pljakobs/Nebelhorn/Front Panel.FCStd

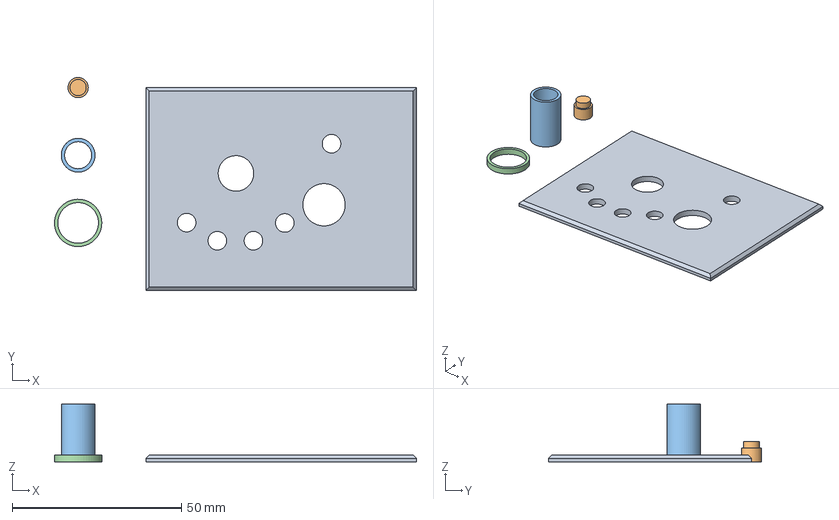
[picture p1: CAD file, 2023-03-14]
Front Panel.FCStd
107.0 x 63.0 x 17.0 mm
Panel
Lightpipe
Shroud
Shim
