pljakobs/Nebelhorn/Nebelhorn-D2PAK.kicad_sch

## KiCad design Nebelhorn-D2PAK.kicad_sch (2023-03-14)

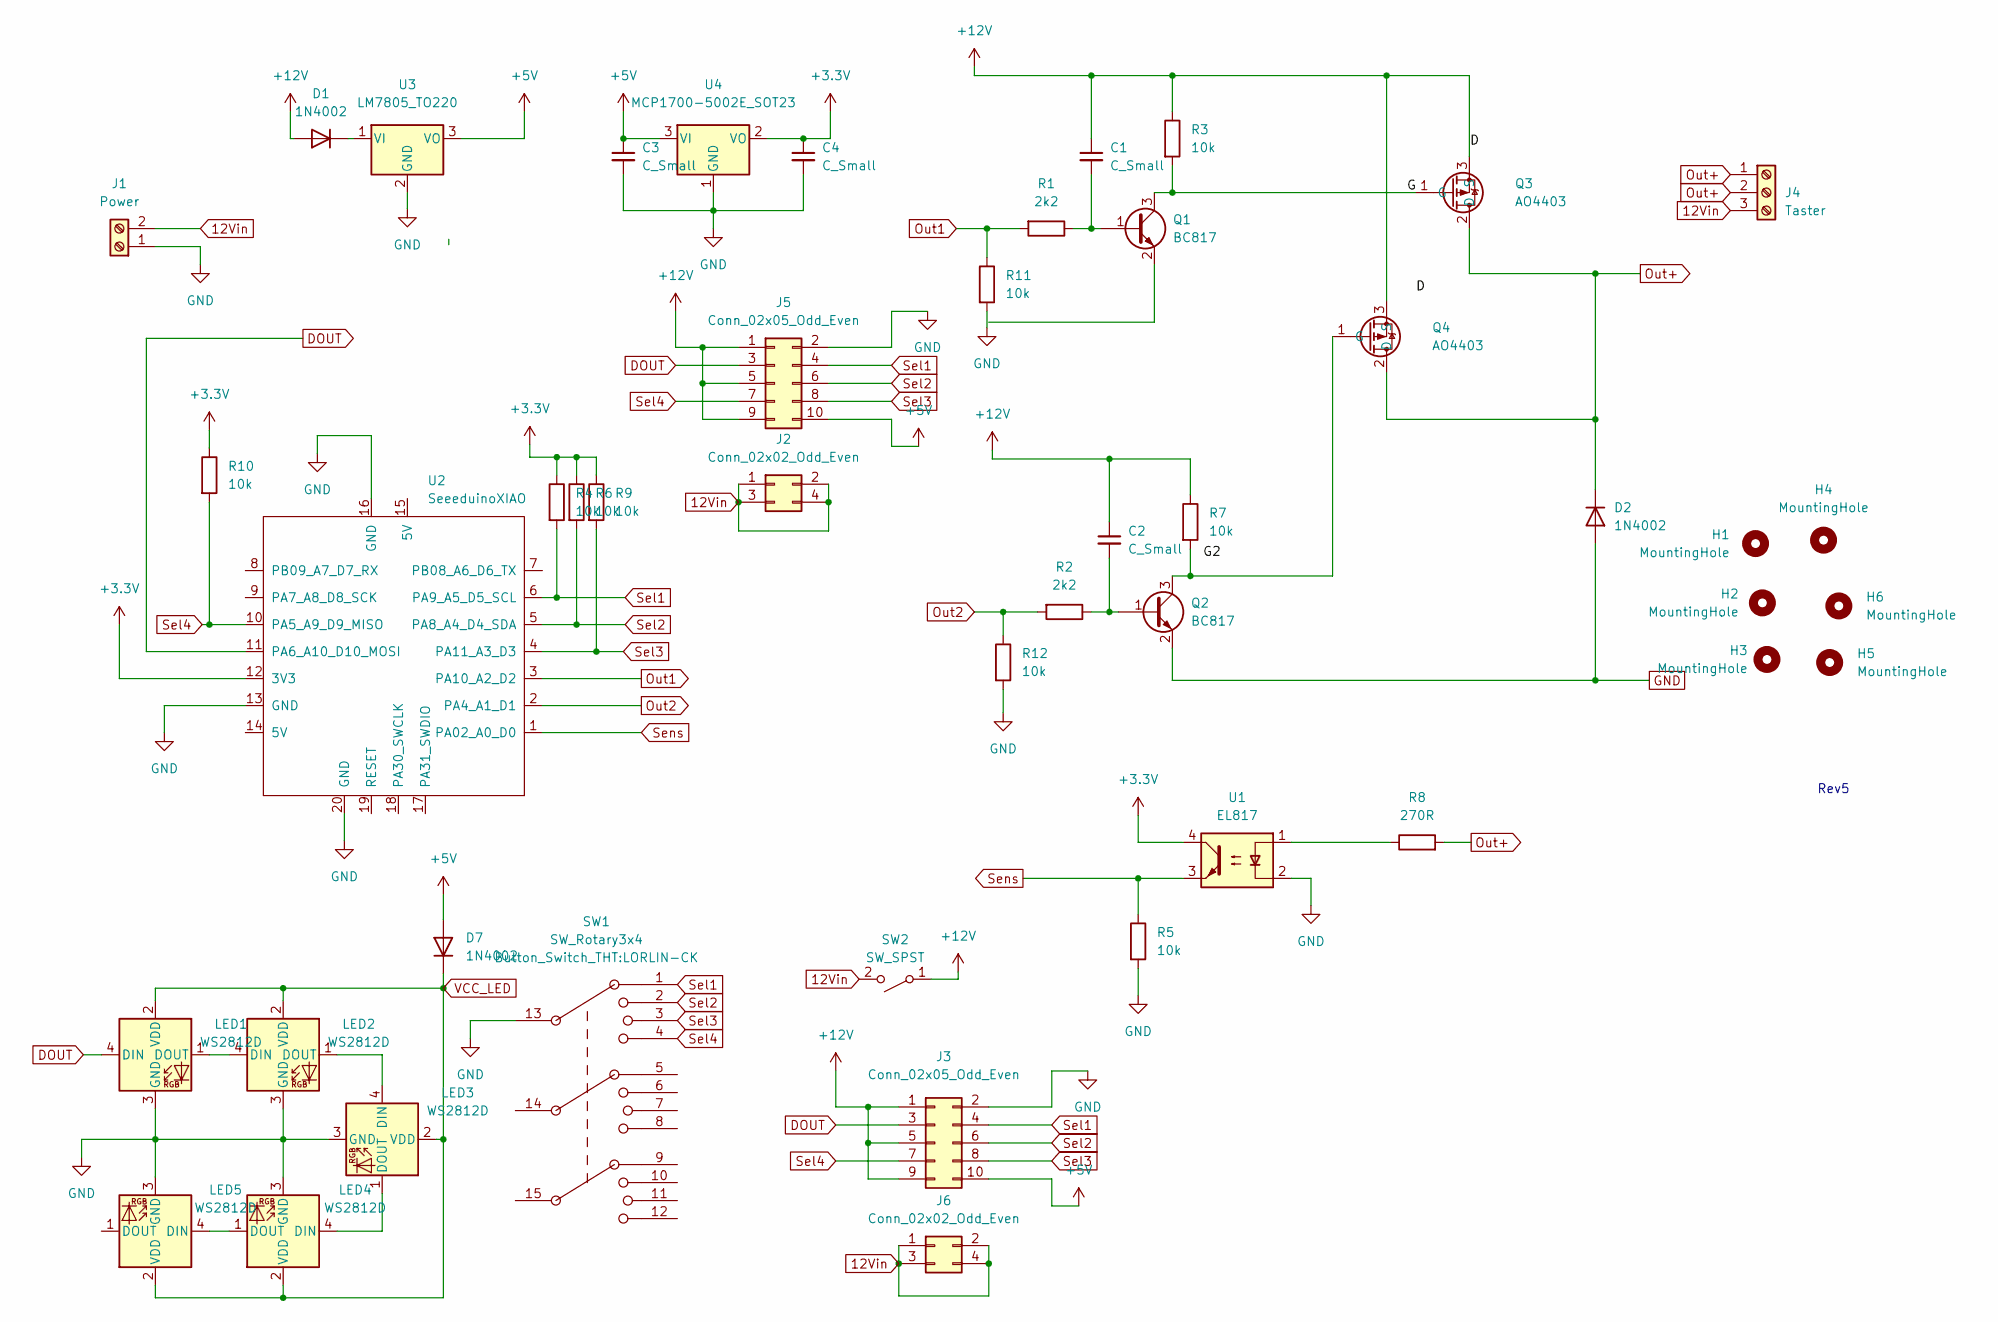
[picture p2: schematic Nebelhorn-D2PAK.kicad_sch]

Parts:
C1, C2, C3, C4: C_Small; C_0805_2012Metric
D1: 1N4002; D_DO-35_SOD27_P7.62mm_Horizontal
D2, D7: 1N4002; D_DO-41_SOD81_P7.62mm_Horizontal
H1, H2, H3, H4, H5, H6: MountingHole; MountingHole_2.5mm
J1: Power; TerminalBlock_MetzConnect_Type101_RT01602HBWC_1x02_P5.08mm_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
J2: Conn_02x02_Odd_Even; PinSocket_2x02_P2.54mm_Vertical
J3: Conn_02x05_Odd_Even; PinSocket_2x05_P2.54mm_Vertical
J4: Taster; TerminalBlock_MetzConnect_Type101_RT01603HBWC_1x03_P5.08mm_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
J5: Conn_02x05_Odd_Even; PinHeader_2x05_P2.54mm_Vertical
J6: Conn_02x02_Odd_Even; PinHeader_2x02_P2.54mm_Vertical
LED1, LED2, LED3, LED4, LED5: WS2812D; LED_D5.0mm-4_RGB
Q1, Q2: BC817; SOT-23
Q3, Q4: AO4403; TO-263-2
R1, R2: 2k2; R_0805_2012Metric
R3, R4, R5, R6, R7, R9, R10, R11, R12: 10k; R_0805_2012Metric
R8: 270R; R_0805_2012Metric
SW1: SW_Rotary3x4; LORLIN-CK
SW2: SW_SPST; Toggle_Switch_SPST
U1: EL817; DIP-4_W7.62mm
U2: SeeeduinoXIAO; Seeeduino XIAO-MOUDLE14P-2.54-21X17.8MM
U3: LM7805_TO220; TO-220-3_Vertical
U4: MCP1700-5002E_SOT23; SOT-23

Connections:
12Vin: J1.2, J2.1, J2.2, J2.3, J2.4, J4.3, J6.1, J6.2, J6.3, J6.4, SW2.2 (B)
+3.3V: C4.1, R4.1, R6.1, R9.1, R10.1, U1.4, U2.12 (3V3), U4.2 (VO)
+5V: C3.1, D7.2 (A), J3.10, J5.10, U3.3 (VO), U4.3 (VI)
+12V: C1.1, C2.1, D1.2 (A), J3.1, J3.5, J3.9, J5.1, J5.5, J5.9, Q3.3 (S), Q4.3 (S), R3.1, R7.1, SW2.1 (A)
DOUT: J3.3, J5.3, LED1.4 (DIN), U2.11 (PA6_A10_D10_MOSI)
G: Q1.3 (C), Q3.1 (G), R3.2
GND: C3.2, C4.2, D2.2 (A), J1.1, J3.2, J5.2, LED1.3 (GND), LED2.3 (GND), LED3.3 (GND), LED4.3 (GND), LED5.3 (GND), Q2.2 (E), R5.2, R11.2, R12.2, SW1.13, U1.2, U2.13 (GND), U2.16 (GND), U2.20 (GND), U3.2 (GND), U4.1 (GND)
unnamed: C1.2, Q1.1 (B), R1.1
unnamed: C2.2, Q2.1 (B), R2.1
unnamed: D1.1 (K), U3.1 (VI)
unnamed: LED1.1 (DOUT), LED2.4 (DIN)
unnamed: LED2.1 (DOUT), LED3.4 (DIN)
unnamed: LED3.1 (DOUT), LED4.4 (DIN)
unnamed: LED4.1 (DOUT), LED5.4 (DIN)
unnamed: Q2.3 (C), Q4.1 (G), R7.2
unnamed: R8.1, U1.1
Out1: R1.2, R11.1, U2.3 (PA10_A2_D2)
Out2: R2.2, R12.1, U2.2 (PA4_A1_D1)
Out+: D2.1 (K), J4.1, J4.2, Q3.2 (D), Q4.2 (D), R8.2
Sel1: J3.4, J5.4, R4.2, SW1.1, U2.6 (PA9_A5_D5_SCL)
Sel2: J3.6, J5.6, R6.2, SW1.2, U2.5 (PA8_A4_D4_SDA)
Sel3: J3.8, J5.8, R9.2, SW1.3, U2.4 (PA11_A3_D3)
Sel4: J3.7, J5.7, R10.2, SW1.4, U2.10 (PA5_A9_D9_MISO)
Sens: R5.1, U1.3, U2.1 (PA02_A0_D0)
VCC_LED: D7.1 (K), LED1.2 (VDD), LED2.2 (VDD), LED3.2 (VDD), LED4.2 (VDD), LED5.2 (VDD)

Notes on the sheet:
Rev5
