pljakobs/Nebelhorn/(commit log)

2023-02-28 initial release
    This is the initial release. The boards are ready to build but the bom might be lacking
    [Nebelhorn.kicad_sch]
2023-03-07 fixed some bugs
    - footprint for WS8212b
    - some bad routing
2023-03-07 fixing a bug where I was killing a non existent task
    [nebelhorn_test.ino]
2023-03-14 numerous changes
    - updated the source to do some more checks
    - added a printable front panel with lightguides and shrouds
    - fixed a few issues on the board
    [Front Panel.FCStd, Nebelhorn-D2PAK.kicad_sch]
